lolo2438/VHDL_GUITAR_PEDAL/Rapport final/Rapport final.docx

Laurent Tremblay

Gr.001

Projet final

Pédale numérique pour effets de guitare

Travail présenté à

M. Jasmin St-Laurent, M. Claude Barbaud et Mme Chantal Milette

dans le cadre du cours

Projet de fin d’études, 243-631 — MA

Collège Maisonneuve

2018-05-14

# Introduction

Dans le cadre du cours de projet de fin d’études, j’ai réalisé un projet électronique ayant comme fonction de modifier un signal audio provenant d’une guitare à l’aide d’un FPGA. Celui-ci possède une interface graphique pour afficher à l’utilisateur l’effet actif ainsi que les paramètres de cet effet. L’utilisateur a à sa disposition deux boutons poussoirs pour avancer et reculer entre les multiples effets ainsi qu’un bouton pour activer les effets audios ou non. Parmi ces effets, on peut retrouver un effet de distorsion et un effet de trémolo. L’effet de distorsion consiste à limiter le signal audio pour ajouter des harmoniques à celui-ci, et l’effet de trémolo consiste à moduler le signal audio à l’aide d’une onde de fréquence très basse, ce qui donne l’impression qu’on augmente et réduit automatiquement le volume du son.

J’ai choisi ce projet, car je joue de la guitare et qu’il est important d’avoir des pédales à effets pour modifier le son de la guitare. Il y a aussi le fait que les pédales à effets pour guitare sont très couteuses, car une pédale peut coûter entre 75 et 500 dollars, et celle-ci ne produit qu’un seul effet. On peut donc s’imaginer qu’on peut se retrouver avec une grosse facture seulement en possédant quelques effets.

L’objectif du projet était donc de pouvoir créer tous les effets voulus pour une fraction du prix que l’ensemble des pédales standard pourraient couter. De plus, ce projet me donnait raison d’utiliser un FPGA, car ceux-ci sont extrêmement puissants pour le traitement de signaux numériques, et par ce fait approfondir mes connaissances au niveau de la composante et du langage VHDL.

# Bilan des travaux

Dans mon cahier des charges, il était spécifié que je devais créer cinq effets différents, chacun ayant trois paramètres modifiables, ainsi qu’implémenter une mémoire vive statique et un écran graphique pour pouvoir créer une pédale numérique. Cependant, suite aux modifications apportées au cours, je me suis vu enlever quelques modules du projet. Ceux-ci étaient trois des cinq effets ainsi que la mémoire vive statique. Suite aux changements, je devais créer deux effets ayant trois paramètres modifiables, soit un effet de distorsion ayant comme paramètres le contrôle du niveau de distorsion, le contrôle du « ton » du son, soit plusieurs filtres passes bas pour couper les hautes fréquences, et un paramètre pour le volume du son, soit un effet de trémolo ayant comme paramètres la fréquence de l’onde modulant le signal, la forme de l’onde modulant le signal et l’intensité de l’effet, ainsi que d’implémenter un afficheur graphique pour l’interface utilisateur. Parmi ces obligations, la seule que je n’ai pu réaliser était le paramètre pour modifier le ton de l’effet de distorsion. Cela est dû au fait que je n’ai pas implémenté la mémoire vive statique dans le projet, et donc dans le FPGA je n’avais pas assez d’espace pour implémenter les filtres nécessaires pour réaliser le circuit. Il y avait une autre option, soit d’utiliser une transformation de fourrier pour faire une analyse fréquentielle du signal et de multiplier les données par des coefficients, cependant je n’ai pas eu le temps d’analyser de sujet et de comprendre comment l’implémenter dans le projet.

# Description générale

## Schéma synoptique

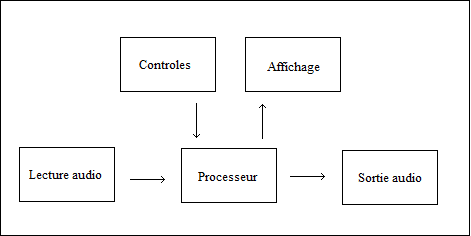
[picture p1: figure]

Le schéma démontre que le projet repose sur un module qui échantillonne un signal audio, et qui envoie les données au processeur, celui-ci traitant le signal qu’il lui est passé dépendamment des contrôles spécifiés par l’utilisateur.

## Schéma de principe

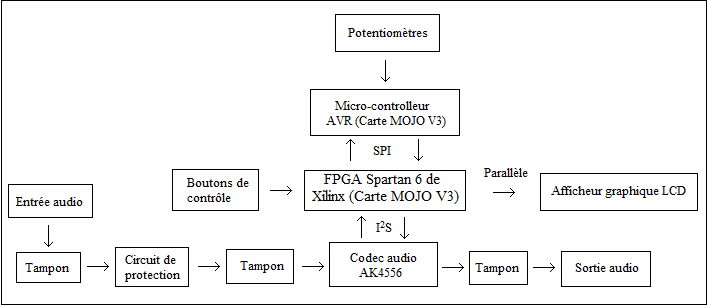
[picture p2: figure]

Il y a plusieurs principes utilisés dans ce projet. Ceux-ci peuvent être séparés en deux : soit une partie analogique et une partie numérique. Pour la partie analogique, il y a l’utilisation de l’amplificateur TL04 comme tampon et comme circuit de protection pour transmettre le signal audio au codec audio AK4556. Il est important d’utiliser un circuit tampon pour isoler les impédances, soit celle de l’entrée audio, celle de l’entrée du circuit d’acquisition du codec audio et celle à la sortie du codec audio. De plus, il faut aussi utiliser un circuit de protection pour limiter le niveau de tension de l’entrée audio, car elle pourrait endommager l’entrée du circuit d’acquisition du codec. Dans mon cas, j’ai choisi d’utiliser un circuit de compression audio : ce circuit ajuste automatiquement la tension du signal audio pour qu’elle soit à une tension fixe, prévenant les surtensions. En plus, ce choix permet d’avoir une meilleure résolution de notre signal audio, cependant il vient couper la dynamique du signal audio. Le deuxième aspect de la partie analogique est l’utilisation d’un codec audio, celui-ci permettant le suréchantillonnage et le filtrage du signal audio. Le but du suréchantillonnage est d’échantillonner le signal à une fréquence très élevée (dans notre cas autour de 512 fois plus élevé) pour augmenter le rapport signal à bruit du signal et pour réduire la taille du filtre anticrénelage nécessaire pour éviter que la fréquence échantillonnée dépasse le théorème de Nyquist-Shannon sur l’échantillonnage. La communication entre le codec audio et le FPGA se fait à l’aide du protocole I²S.

Pour la partie numérique, on peut retrouver une interface pour l’utilisateur ainsi que plusieurs protocoles de communications. L’utilisateur possède trois boutons de contrôles, soit deux pour changer de pages (précédent et prochain) ainsi qu’un bouton activant la pédale. L’utilisateur peut aussi modifier les paramètres des effets à l’aide de trois potentiomètres. Les tensions de ces potentiomètres sont lues à l’aide des convertisseurs analogiques à numérique du microcontrôleur AVR sur la carte MOJO V3. Ils sont ensuite transmis à l’aide du protocole SPI au FPGA Spartan 6. Le dernier item de l’interface utilisateur est un afficheur graphique LCD. Le FPGA envoie des données en parallèle à l’afficheur, car l’interface est plus facile à implémenter par rapport à un protocole comme le SPI ou le I²C.

# Description précise

## Schéma de montage

### Plaquette principale

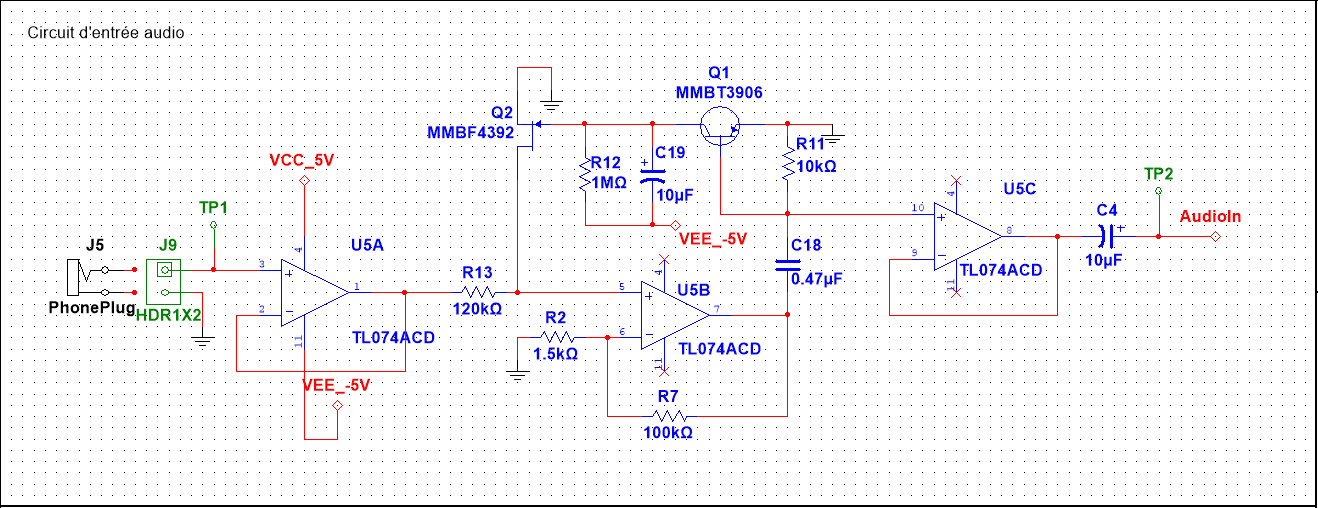
[picture p3: figure]

Le circuit d’entrée audio comporte trois étages. Le premier étage est un suiveur qui isole l’impédance de la guitare et celle du circuit. Le deuxième étage est un circuit de compression audio, régulant le signal d’entrée pour qu’il soit toujours à 1,31 volt. Ce circuit est important pour protéger l’entrée du convertisseur analogique à numérique du codec audio AK4556. De plus, il permet d’utiliser une plus grande résolution du convertisseur analogique à numérique. Le troisième étage est un autre suiveur qui isole l’impédance du circuit de compression et l’impédance du convertisseur analogique à numérique du codec audio. Il possède un condensateur à sa sortie pour couper le décalage courant continu.

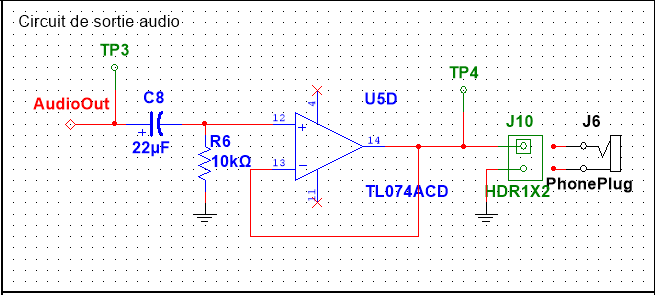
[picture p4: figure]

En contrepartie, le circuit audio de sortie comporte un seul étage, soit un circuit suiveur, qui vient isoler la sortie du convertisseur numérique à analogique du codec audio AK4556. Il possède aussi un filtre passe-haut à son entrée pour couper le décalage courant continu.

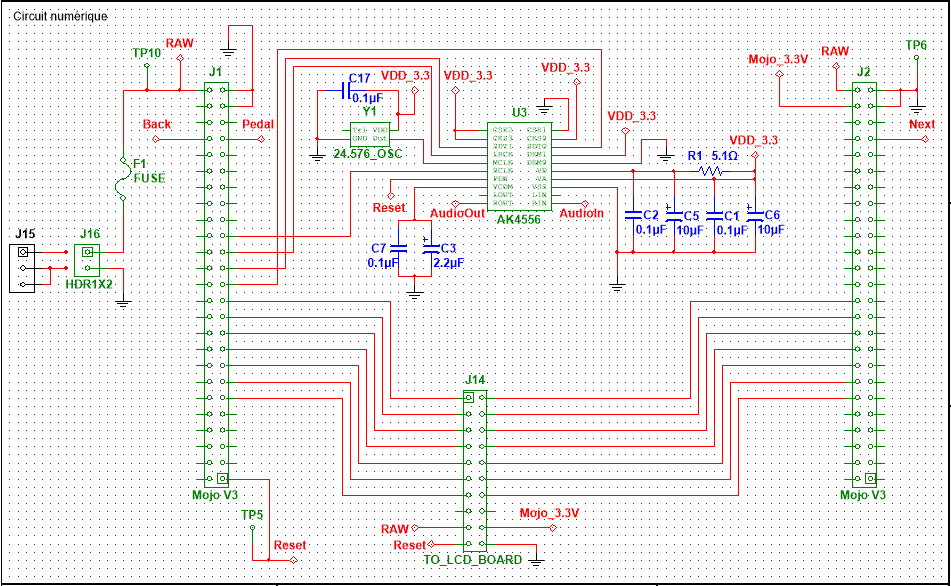
[picture p5: figure]

Le circuit principal du projet se retrouve ici. Le connecteur J15 est une entrée pour le bloc d’alimentation 9 V. Le connecteur J14 permet le lien entre la plaquette principale et la plaquette pour l’écran graphique. Les connecteurs J1 et J2 font le lien entre la carte Mojo et les circuits du projet. Dans ce circuit, on retrouve le codec AK4556, qui est responsable de l’échantillonnage du signal audio.

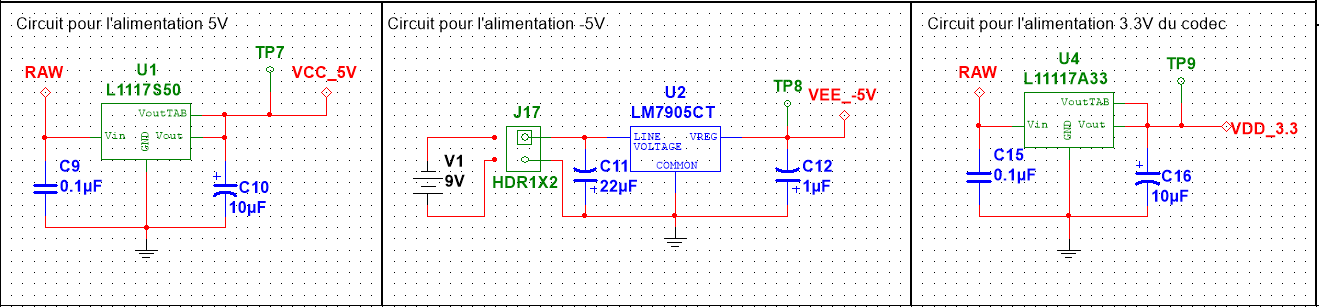
[picture p6: figure]

La plaquette utilise trois alimentations, soit 5 volts et -5 volts pour l’alimentation de l’amplificateur opérationnel TL074 utilisé dans les circuits audios, ainsi que 3,3 V pour alimenter le codec audio. Il est important de noter que la carte Mojo V3 possède ses propres régulateurs, alors la tension brute du bloc d’alimentation est directement liée à l’entrée de la carte. Aussi, une pile 9V est nécessaire pour obtenir la tension négative requise de l’amplificateur opérationnel TL074.

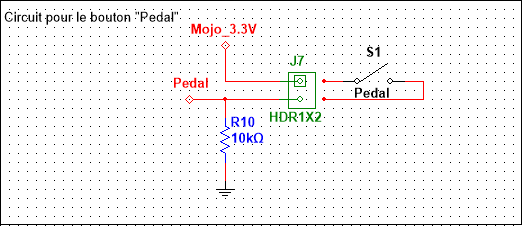
[picture p7: figure]

Le même circuit est utilisé pour les boutons « Pédale », « Suivant » et « Précédent ».

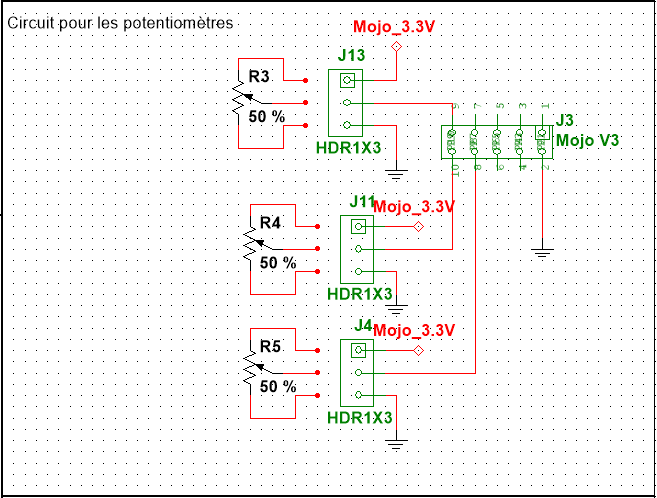
[picture p8: figure]

Ce circuit est utilisé pour pouvoir lire la tension des potentiomètres utilisés pour modifier les paramètres des effets. Ceux-ci sont connectés au connecteur J3, qui est relié aux convertisseurs analogiques à numériques du microcontrôleur Atmel de la carte Mojo.

**Le circuit principal complet peut être trouvé à l’annexe.

### Circuit pour l’écran graphique

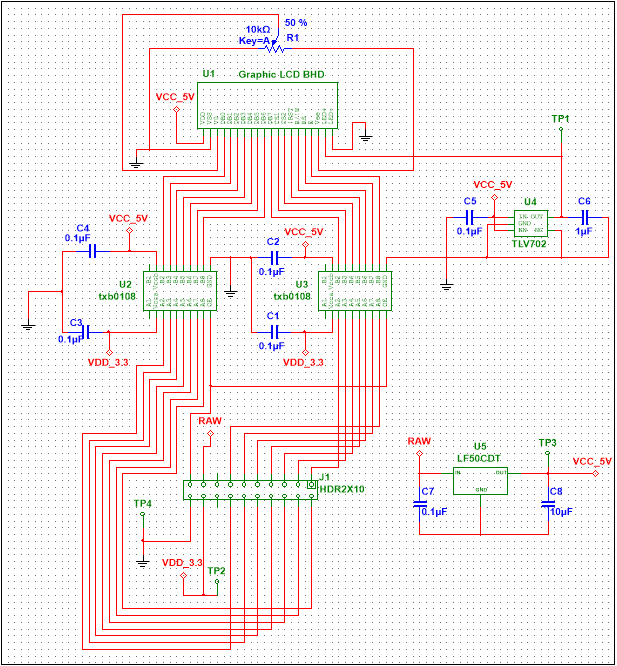
[picture p9: figure]

Ce circuit est le circuit complet pour interfacer l’afficheur LCD avec le FPGA. Le connecteur J1 permet la liaison entre les deux plaquettes. Le circuit possède deux régulateurs : un LF50CDT régule la tension à 5 V, soit l’alimentation nécessaire pour la logique de l’écran, et un TLV02 qui régule la tension à 3,5 V, soit l’alimentation nécessaire pour alimenter le rétroéclairage de l’écran. Le circuit possède aussi deux composantes TXB0108, qui eux convertissent la tension provenant des tampons de sortie du FPGA, soit 3,3 V, à la tension nécessaire pour la logique de l’écran, soit 5V.

## Circuit imprimé

### Circuit imprimé pour le circuit principal

Copper Top

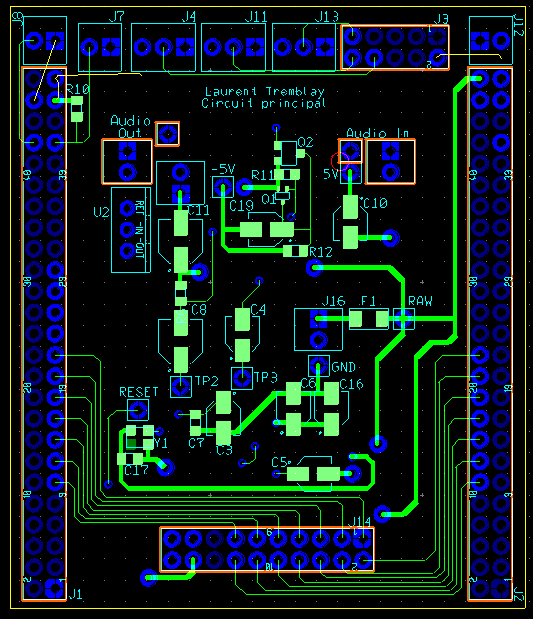
[picture p10: figure]

« Copper Bottom »

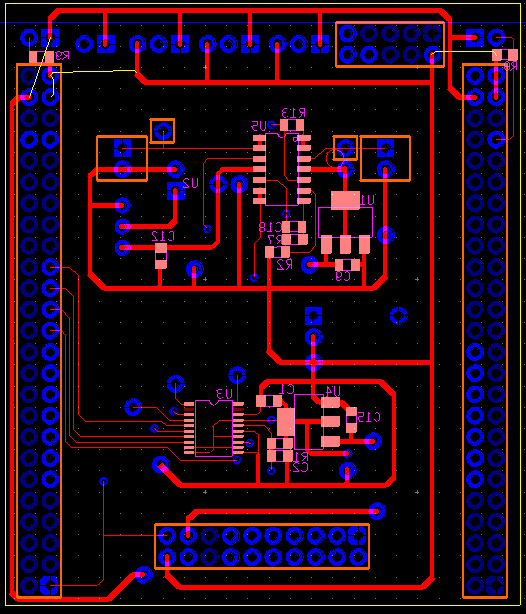
[picture p11: figure]

Les images ci-haut sont les côtés haut (top) et bas (botom) du circuit principal. Les connexions non reliées en jaune sont effectuées lorsque le circuit est inséré dans la carte Mojo V3. De plus, l’erreur indiquée par le point de test de l’entrée audio et de l’alimentation 5V étant trop rapproché n’est pas réellement une erreur étant donné que ceux-ci sont à 100 millièmes de pouce de distance.

### Circuit imprimé pour l’écran LCD

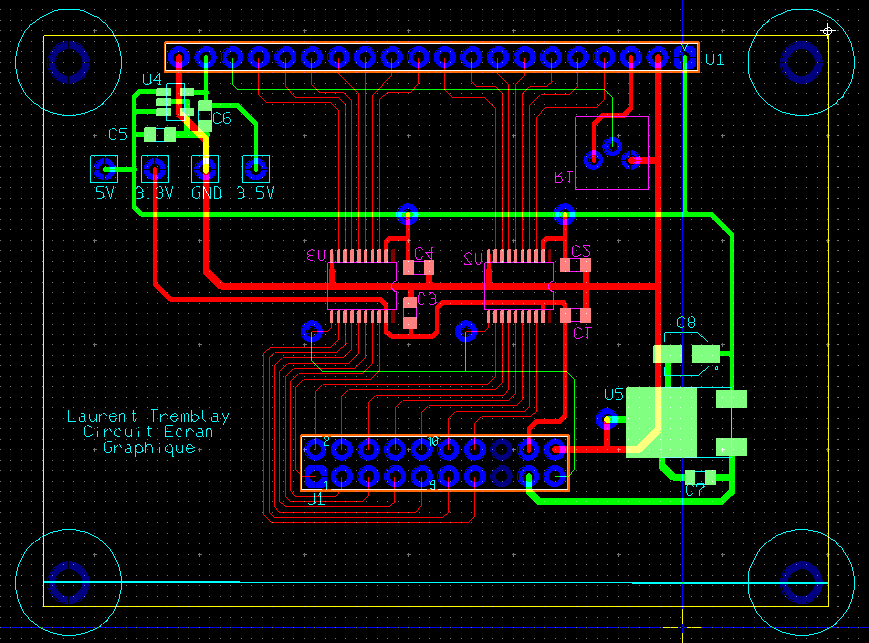
[picture p12: figure]

Ce circuit imprimé est utilisé pour alimenter l’écran graphique et pour transformer la tension 3.3V provenant FPGA pour qu’il soit converti à 5 V. La ligne bleue sérigraphiée vers le bas de la plaquette nous indique où il faut couper pour enlever l’excès.

## Câbles

Le projet utilise deux types de câbles : un câble de type ruban plat et des câbles sertis qui sont insérés dans les connecteurs.

Le câble plat est utilisé pour échanger des données entre la carte principale et la carte de l’écran LCD. Il comporte 20 conducteurs ayant une taille de 28 AWG et doit être d’une longueur de 7 pouces.

Les câbles sertis sont utilisés pour attacher les composantes externes, soit les boutons, les potentiomètres, l’entrée et la sortie audio, ainsi que l’alimentation, au circuit principal. Ils ont tous une taille de 22 AWG. Les câbles des alimentations ont une longueur d’environ cinq pouces et doivent être de couleur rouge pour l’alimentation, et noire pour la masse. Les câbles pour les boutons et les potentiomètres, qui eux ont une longueur d’environ 2,5 pouces, suivent la même règle de couleur pour les alimentations, cependant le câble comportant les données numériques ou analogiques doit être de couleur blanche. Finalement, les câbles portant les informations du signal audio sont de couleur bleue et à une longueur d’environ 2,5 pouces.

## Programmes

Circuit principal (« TOP »)

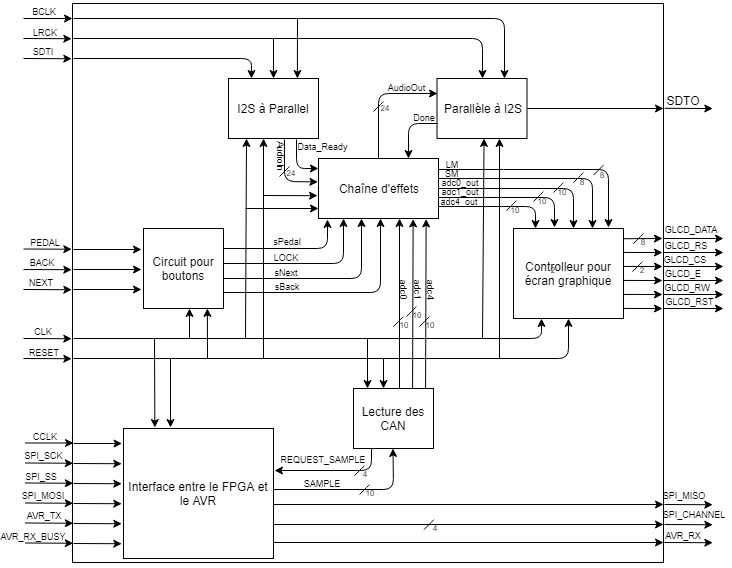
[picture p13: figure]

I²S à Parallèle

Ce module permet la réception de données I2S provenant du codec audio AK4556. Il reçoit une trame de 24 bits qui sont échantillonnés sur front montant de l’horloge « bit », et qui représentent les canaux audios droit et gauche dépendamment du niveau de l’horloge « Left/Right (LR) ». Le processus est réalisé à l’aide d’un registre à décalage, qui lorsque plein, envoie un signal à l’utilisateur.

Parallèle à I²S

Ce module permet de prendre un registre et de le convertir en trame I2S. Pour ce faire, le module détecte un changement de niveau logique dans l’horloge sélectionnant le canal droit ou gauche, puis envoie les bits du registre à l’aide d’un registre à décalage. Lorsque toutes les données sont envoyées, le module envoie un signal disant qu’il est prêt à recevoir une nouvelle donnée dans son registre.

Interface entre le FPGA et le AVR

Ce module a été écrit par l’équipe de Embedded Micro en Verilog, puis a été traduite en VHDL par l’utilisateur Xark. Il est libre d’utilisation pour tous. Le module permet de faire la communication entre le microcontrôleur AVR et le FPGA se retrouvant sur la carte Mojo V3 pour ainsi lire les convertisseurs analogiques à numérique du microcontrôleur AVR. La communication entre les deux composantes se fait à l’aide du protocole SPI. L’interface permet aussi d’envoyer des données UART, cependant cette fonctionnalité n’est pas utilisée dans le cadre du projet.

Lecture des CAN

Ce module a été écrit dans le but de gérer l’entrée de donnée des convertisseurs analogiques à numériques. Il communique directement avec le circuit d’interface entre le FPGA et le AVR en lui demandant le canal du convertisseur analogue à numérique qu’il veut lire. Le module échantillonne 10 fois le convertisseur analogue à numérique avant d’entreposer la 11e donnée dans un registre. Cela permet au convertisseur du microcontrôleur AVR de se stabiliser, car sinon les données sont erronées. Il exécute les mêmes actions pour les autres canaux, pour revenir finalement au canal de départ.

Chaîne d’effets

Ce module permet de facilement enfiler et de sélectionner les effets programmés dans le FPGA. Il permet aussi de facilement interfacer les paramètres actifs de l’effet ainsi que le statut de l’effet, soit s’il est sélectionné ou s’il est bloqué, au circuit du contrôleur de l’écran graphique.

Distorsion

L’effet de distorsion consiste à ajouter des harmoniques au signal échantillonné. Le principe utilisé pour appliquer cet effet est d’appliquer un seuil au signal d’entré, et de couper tout ce qui plus grand (et plus petit lorsque le signal est négatif). Plus on augmente le niveau de distorsion, plus on augmente le gain appliqué à l’onde d’entrée, et étant donné que le seuil reste fixe, la forme de l’onde devient de plus en plus carrée. On peut ensuite décider d’amplifier le volume de l’onde distorsionnée à l’aide du paramètre de volume, qui vient multiplier cette onde par un gain variable. Bien que le paramètre modifiant le ton du signal n’ai pas été implémenté, il peut être retrouvé dans le fichier toneFiltreFIR.vhd inclus à l’annexe. Il consiste de 15 filtres impulsionnels à réponse fini de 39 coefficients qui sont sélectionnables à l’aide de la valeur du convertisseur analogue à numérique #1. En changeant la fréquence des filtres, on vient faire en sorte que la tonalité du signal devient plus grasse ou plus aiguë. Le programme devrait être plus optimisé lors de l’utilisation d’une mémoire vive statique.

Trémolo

L’effet de trémolo consiste à multiplier le signal échantillonné par une onde de basse fréquence, ce qui donne l’impression qu’on augmente et diminue le son du signal rapidement. Pour appliquer cet effet, le module génère une onde triangulaire ou carrée, dépendamment du paramètre nommé « wave », qui signifie forme de l’onde, puis on multiplie le signal entrant dans le module par la cette onde. On peut choisir de réduire ou d’augmenter la fréquence de l’onde générée en modifiant le paramètre « rate ». On peut aussi modifier l’intensité de l’effet en modifiant le paramètre « depth ». Le principe de l’intensité consiste à augmenter ou réduire la plage de l’onde générée. En effet, si on assume que l’effet n’est en fait qu’un gain variable, en réduisant la plage du gain, on réduit l’écart entre les niveaux de tensions, ce qui fait en sorte que l’effet est moins remarqué.

Circuit pour boutons

Ce module permet d’analyser les boutons disponibles à l’utilisateur. Ce module se sépare en deux catégories : le bouton qui active la pédale et les deux boutons pour changer le type d’effet appliqué. Parmi les sous-modules utilisés, il y a un module d’anti rebond créer par le professeur Jasmin St-Laurent du collège de Maisonneuve. J’ai obtenu son autorisation pour l’utilisation de son module.

Bouton « pédale »

Pour le signal du bouton contrôlant si la pédale est active ou non, étant donné que le circuit de ce bouton est en fait un interrupteur ouvert ou fermé, on applique un anti-rebond de 10 millisecondes. En parallèle, il y a un processus qui observe si l’utilisateur réappuie sur le bouton dans l’espace de 500 millisecondes. Si c’est le cas, un signal est envoyé au module s’occupant des effets, indiquant que l’utilisateur veut bloquer les paramètres de l’effet actuellement actif.

Bouton « suivant » et « précédent »

Pour le signal des boutons suivant et précédent, on applique un anti-rebond de 10 millisecondes, puis lorsque l’anti-rebond est appliqué, on envoie un signal durant un coup d’horloge au module d’effet indiquant qu’on change d’effet.

Contrôleur pour écran graphique

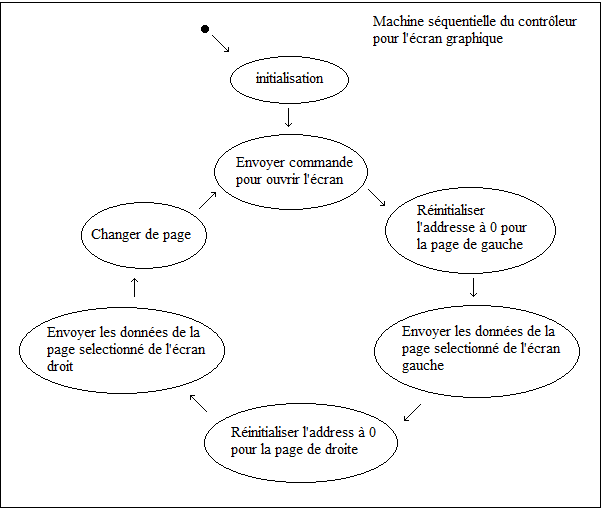
[picture p14: figure]

Le module contrôlant l’écran graphique est une machine séquentielle ayant 7 états, ceux-ci étant synchronisés sur une horloge nommée E pour « enable » (activé). Lorsqu’il y a un front descendant sur cette horloge, le contrôleur sur la carte de l’écran graphique lit les données. La machine séquentielle recharge ses données sur le front montant de cette horloge, puis effectue ses actions sur le front descendant, soit de changer d’état ou d’incrémenter des compteurs, étant donné que l’écran lit les données chargées lors du front montant. Le premier état est celui de l’initialisation, où on met tous les signaux ainsi que les variables du processus a leurs valeurs initiales. De plus, on applique un signal « reset » au contrôleur de l’écran pendant 2,4 microsecondes. On tombe ensuite dans l’état où on envoie la commande nécessaire pour ouvrir l’écran. On passe ensuite au prochain état où on envoie les 64 premiers octets de la page, soit la moitié de l’écran. Lorsque tout est envoyé, on change pour le côté droit de l’écran et on réinitialise l’adresse à 0. On envoie ensuite les 64 derniers octets pour du tableau de donnés, et lorsque cela est fait, on envoie une commande à l’écran pour qu’il change de page. Pour s’assurer que l’écran fonctionne toujours, même si on le débranche ou que le FPGA s’allume avant celui-ci, on renvoie la commande pour allumer l’écran.

Plan

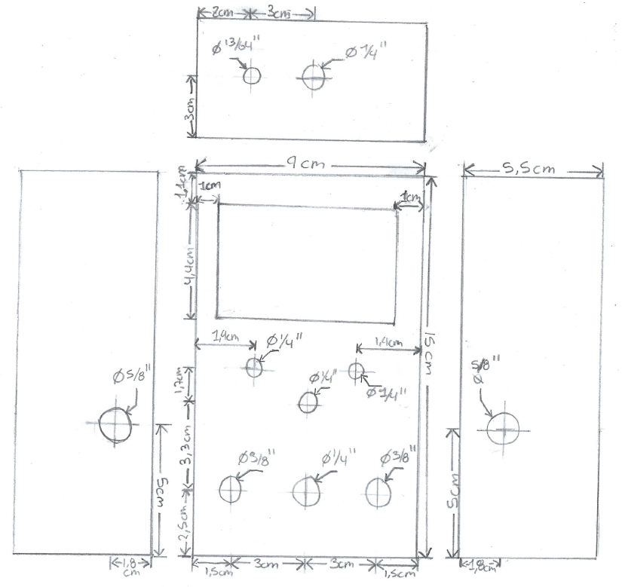
[picture p15: figure]

Les dimensions du boitier sont spécifiées en centimètres.

Les dimensions des trous sont spécifiées en pouces, pour faciliter la sélection de la taille de la mèche utilisée pour percer le trou.

Le boitier utilisé est en plastique. Ce choix a été fait à cause de son faible coût et sa facilité de manipulation.

## Caractéristiques et limites de l’appareil

Consommation d’énergie : Alimentation positive : 1,35 Watt

Alimentation négative : 0,045 Watt

Autonomie : 100 heures avant de changer la batterie

Type d’alimentation : Prise murale 9V et pile 9V

Milieu : Maison et studio

Température : 0º Celsius à 40º Celsius

Plage de fonctionnement : Fréquence minimale pouvant être échantillonnée : 20 Hz

Fréquence maximale pouvant être échantillonnée : 24 kHz

Vitesse d’acquisition du signal audio : 48 kHz

## Liste de matériel

Processeur

* Le circuit principal est inséré dans la carte Mojo V3, d’où son absence de RefDes

Composantes passives

* Le bouton activant la pédale ne se retrouve pas sur le site internet de Digikey, il peut être acheté chez Addison (lien internet (https://addison-electronique.com/interrupteur-a-bouton-poussoir-on-off-2-pins-spst.html)).

Composantes actives

Connecteurs

* Le connecteur est représenté par la composante de l’écran LCD

** il est préférable d’acheter des connecteurs de taille standard et de les couper, pour des raisons de coût trop élevé.

Accessoires

* Le boitier utilisé ne se retrouve pas sur Digikey, il peut être acheté chez Abra Electronics (lien internet (https://abra-electronics.com/enclosures-boxes/plastic-box-generic/gpb435-plastic-box-4.875l-x-2.5w-x-1.5h.html)).

## Évaluation des coûts de production

Les coûts de production se séparent en cinq catégories : le processeur, les composantes passives, les composantes actives, les connecteurs et les accessoires.

Le processeur central, soit le FPGA, se retrouve sur la carte Mojo V3, qui elle se vend à 129,96 CAD.

Les composantes passives, soit les résistances, les potentiomètres, les condensateurs, les boutons, l’interrupteur pour l’alimentation et le fusible, coûtent au maximum 22 dollars canadiens, le plus cher étant les boutons et les potentiomètres.

Les composantes actives, soit les régulateurs, les transistors, l’amplificateur opérationnel, l’adaptateur de tension, l’écran graphique ainsi que le codec audio, sont estimées à un coût total d’environ 42 dollars canadiens, le plus cher étant l’écran graphique coûtant 32 dollars canadiens.

L’ensemble des connecteurs, incluant les pièces pour sertir les câbles, le connecteur pour le bloc d’alimentation, le connecteur pour la pile 9 volts, les connecteurs pour les entrées audios et le câble en ruban 20 positions, coûtent autour de 25 dollars canadiens, le plus cher étant le câble ruban, celui-ci coutant 7,50 $.

Les accessoires englobent toutes les parties du projet qui sont externes. Ils peuvent coûter plus ou moins cher et sont facilement remplaçables. Cela comprend les poignées des potentiomètres, la pile 9V, le bloc d’alimentation 9 volts ainsi que le boitier. Le coût des accessoires est estimé à 35 dollars canadiens.

Au total, le projet est estimé à 255 dollars canadiens sans taxes et sans circuits imprimés.

# Procédure d’assemblage

Étape 1 : Imprimer circuits

Pour faire imprimer les circuits imprimés du projet, il faut envoyer les fichiers gerber à une compagnie pour qu’ils les fassent. En effet, certaines traces sont trop petites pour que la plaquette soit faite à la maison. Un site recommandé pour l’impression des plaquettes est allPCB. Ceux-ci envoient en une semaine des plaquettes professionnellement faites à un faible prix.

Étape 2 : Souder composantes

Lorsque les plaquettes ont été reçues, il faut souder toutes les composantes en se référant au schéma Multisim et Ultiboard inclus à l’annexe pour s’assurer que toutes les composantes sont soudées à la bonne place. Un fer à souder chauffer à une température de 400 dégrées Celsius, de l’étain de taille 22 AWG pour les composantes soudées dans les trous et de l’étain de taille 27 AWG sont les outils nécessaires pour souder les composantes montées en surface. Il est fortement recommandé d’utiliser un microscope pour souder les composantes montées en surface.

Étape 3 : Percer boitier

En suivant les détails spécifiés plus hauts sur le boitier, il suffit de suivre les schémas pour percer les trous des tailles spécifiés à la bonne place à l’aide d’une perceuse. Lorsque le trou est très gros, il est préférable de commencer par percer un trou plus petit et augmenter de taille progressivement pour ne pas briser le matériel du boitier. Pour le trou de l’écran, il faut utiliser une scie rotative pour créer un trou un peu plus petit que celui étant spécifié et ensuite sabler les côtés pour que l’écran soit serré.

Étape 4 : Sertir les câbles et les insérer dans les connecteurs

En utilisant un outil pour sertir des câbles d’une taille de 22 AWG, on peut sertir les connecteurs à sertir aux câbles mentionnés plus hauts. Il est seulement nécessaire de sertir qu’un seul côté du câble, étant donné que l’autre côté sera soudé à un périphérique externe. Pour sertir un câble, il suffit de dégainer environ 0,5 cm de celui-ci à l’aide d’un outil pour dégainer et de le sertir à l’aide de l’outil à sertir. Lorsque tous les câbles sont sertis, il faut les insérés dans le connecteur correspondant, suivant le code de couleur indiqué dans la section câble, soit rouge pour alimentation positive ou négative, noir pour la masse, blanc pour données des potentiomètres et des boutons ainsi que bleu pour l’entrée et la sortie audio. Pour le câble en forme de ruban, il faut fermer les deux connecteurs femelles 20 positions sur le câble à l’aide d’un étau pour bien le dégainer.

Étape 5 : Souder les fils aux périphériques externes

La partie non sertie des câbles doit être soudée aux périphériques externes, soit les potentiomètres, l’alimentation, les boutons et les entrées audios. Pour ce faire, il faut commencer par dégainer environ 1 centimètre du câble et de faire une forme de crochet avec celui-ci. Il faut ensuite placer un tube thermo rétractable d’une longueur d’environ 1,5 cm autour du câble à souder et de le garder loin de la chaleur du fer. Lorsque cela est fait, il ne reste que d’insérer le crochet dans la fente prévue de la pièce, tout en suivant le schéma électrique, de souder le câble à la composante, et de chauffer le tube thermorétractable par-dessus la nouvelle soudure, évitant ainsi les possibilités de courts-circuits.

Étape 6 : Installer les cartes et les composantes externes

Pour cette étape, il suffit d’installer les composantes externes dans leurs trous respectifs. Il faut aussi installer la pile 9VDC ainsi que les poignées pour les potentiomètres. Lorsqu’on installe les poignées, il faut s’assurer que lorsque la tension sortant du potentiomètre est de 1.65VDC. Lorsque cela est le cas, il suffit d’aligner la barre blanche de la poignée pour qu’elle pointe droit vers l’écran. En se référant au manuel de l’utilisateur ainsi qu’aux deux images ci-dessous, on peut observer l’emplacement de chaque composante par rapport aux schémas de boitiers.

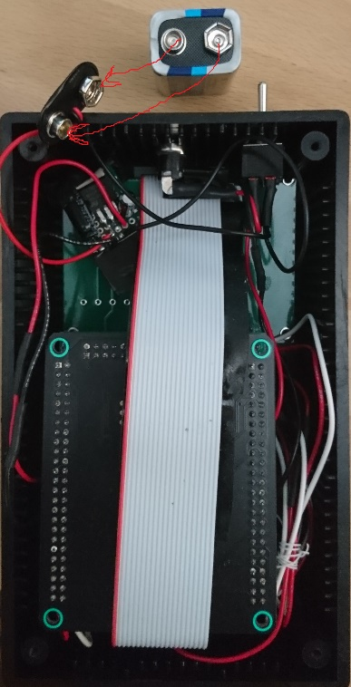
[picture p16: figure]
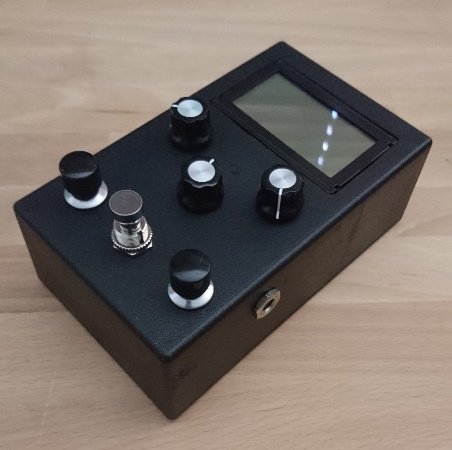
[picture p17: figure]

Étape 7 : Installer le programme

Lorsque le projet est alimenté par l’alimentation externe ainsi que la pile 9VDC, il faut connecter un câble USB de type micro à la carte Mojo V3 et le connecter à un ordinateur. Il faut ensuite installer le programme nommé « Mojo loader » (lien pour téléchargement (https://embeddedmicro.com/pages/mojo-loader)), créer par l’équipe de Embedded Micro, soit les concepteurs de la carte Mojo v3, pour pouvoir programmer la carte. Lorsque le programme sera ouvert, suffit de choisir le port de communication de la carte, de rechercher le fichier PedaleMultiEffets.bit, soit le circuit du projet, à l’aide du bouton « Browse », de cocher le bouton « Store to Flash » et « Verify Flash » pour que le programme soit chargé même si l’alimentation est coupée et finalement d’appuyer sur le bouton « Load » pour télécharger le programme dans le FPGA ainsi que sa mémoire externe.

# Procédure de calibration

Le projet requiert quelques calibrations. La première est d’ajuster le potentiomètre « R1 », sur le circuit imprimé de l’écran, pour ajuster le rétroéclairage du LCD. Il faut ajuster cette résistance pour que la tension obtenue à la broche #3 de l’écran graphique soit de -3,5 volts. La deuxième calibration implique que les trois potentiomètres utilisés pour la modification des effets sont installés dans le boitier. Il faut les ajuster pour que la tension affichée sur leur broche du milieu soit de 1,65 volt. Lorsque cela sera le cas, il faudra installer les poignées pour que la petite barre blanche pointe droit vers l’écran.

# Manuel de l’utilisateur

La pédale à multieffets numériques permet d’appliquer plusieurs effets à votre guitare pour créer le son qui vous convient. Celle-ci est équipée de trois sélecteurs qui permettent de modifier les paramètres des effets, de deux boutons pour changer l’effet actif, d’un bouton pour activer ou désactiver l’application de l’effet ainsi qu’un interrupteur pour activer ou désactiver l’alimentation.

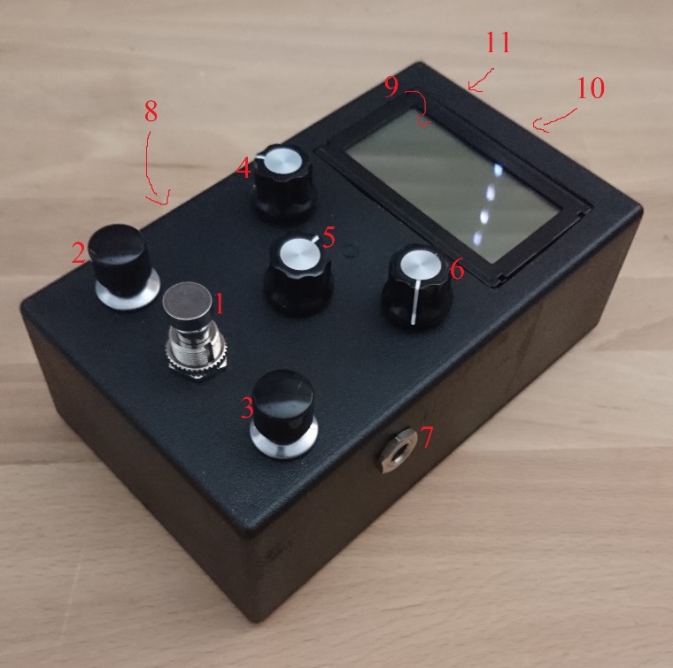
[picture p18: figure]

1. Activer ou désactiver la pédale

2. Effet précédent

3. Effet suivant

4. Paramètre nº 1 de l’effet

5. Paramètre nº 2 de l’effet

6. Paramètre nº 3 de l’effet

7. Entrée audio mono

8. Sortie audio mono

9. Affichage pour l’utilisateur

10. Entrée pour alimentation murale 9VDC*

11. Interrupteur pour activer l’alimentation

*Attention, l’alimentation murale doit respecter ce symbole :

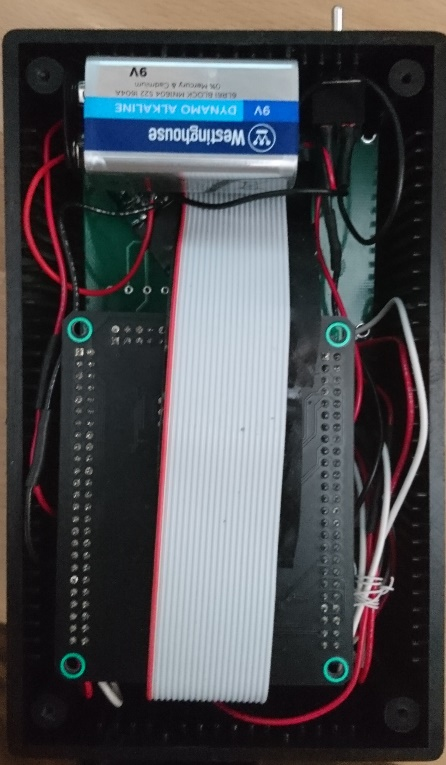
[picture p19: figure]

Pour utiliser l’appareil, il faut en premier lieu brancher une pile 9V à l’intérieur de la pédale. À l’aide d’un tournevis en forme étoile, on enlève les quatre vis sous l’appareil pour révéler le circuit. Lorsque cela est fait, il faut remettre les quatre vis et fermer le boitier.

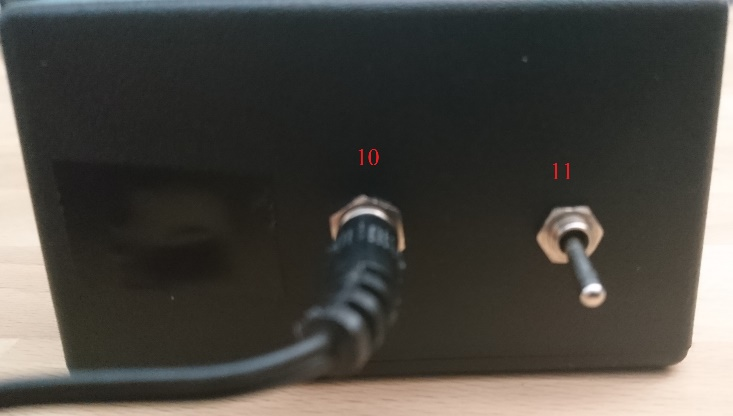
[picture p20: figure]

Il faut ensuite insérer l’alimentation 9VDC et activer l’interrupteur.

Lorsque l’interrupteur est vers le bas, l’alimentation est coupée, et lorsqu’il est vers le haut, le circuit est alimenté.

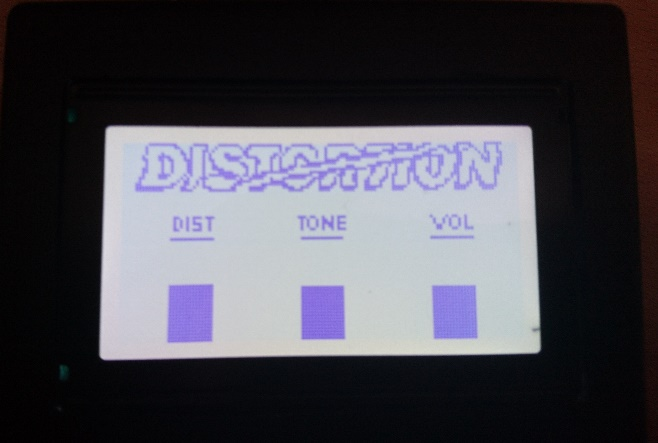
[picture p21: figure]

Lorsque la pédale sera alimentée, l’écran s’ouvrira et affichera le premier effet de la liste, soit l’effet de distorsion ici. À partir d’ici, on peut jouer avec les trois sélecteurs (4,5 et 6) pour modifier les paramètres de l’effet. Ces sélecteurs sont alignés respectivement avec les paramètres affichés à l’écran.

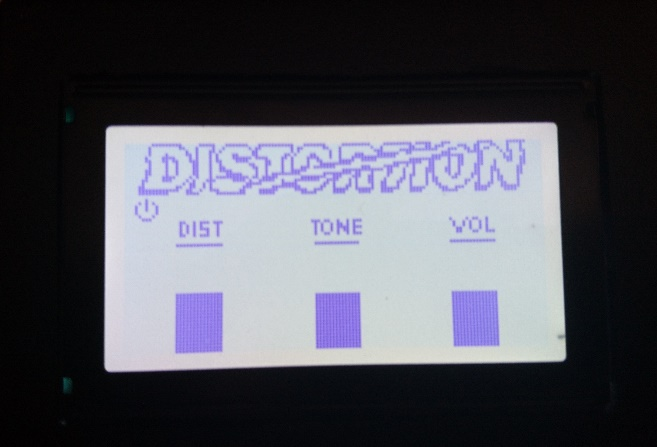
[picture p22: figure]

Lorsqu’on appuie sur le bouton nº 1, un symbole va s’afficher en haut, à gauche de l’écran, nous indiquant que l’effet est actuellement actif.

Lorsqu’on appuie deux fois sur le bouton nº 1, un symbole va s’afficher en haut, à droite de l’écran, nous indiquant que l’effet est actuellement bloqué. Cela veut dire que l’on ne peut plus changer les paramètres de l’effet tant et aussi longtemps que l’on ne débloque pas le module, soit en réappuyant deux fois sur le bouton nº 1.

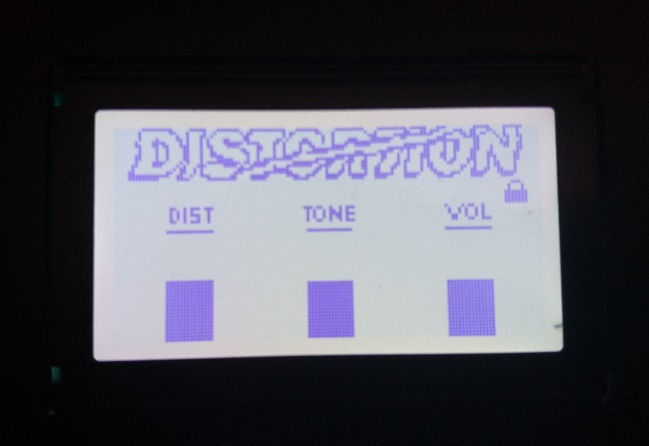
[picture p23: figure]

En appuyant sur les boutons nº 2 et nº 3, on peut changer l’effet appliqué sur le son de la guitare. L’afficheur indiquera l’effet actuellement actif.

Il faut insérer la sortie de la guitare dans l’entrée audio (nº 7), et la sortie audio (nº 8) dans l’entrée de l’amplificateur.

L’appareil a été conçu dans le but d’être utilisé à l’intérieur d’un bâtiment ayant des conditions optimales, soit une température autour de 20 dégrées Celsius, ainsi qu’un taux d’humidité convenable. Il est donc fortement déconseillé d’utiliser l’appareil à l’extérieur, étant donné que celui-ci n’est pas résistant aux intempéries, aux hautes températures ainsi qu’aux hauts taux d’humidité. L’appareil ne peut pas non plus être utilisé ni entreposé à une température au-dessous de zéro dégrées Celsius. Il est fortement déconseillé de l’utiliser pour des concerts extérieurs.

Il est important de ne pas utiliser une alimentation murale supérieure à 9 volts courants continus, car l’équipement n’est pas conçu pour de hautes tensions. Il est important aussi de noter que contrairement à l’équipement standard de musique, le connecteur de l’alimentation murale doit être positif au centre et négatif autour (symbole plus haut dans le manuel). Il est fortement conseillé de désactiver l’alimentation à l’aide de l’interrupteur (nº 11) avant de changer la batterie ou d’insérer le connecteur de l’alimentation murale. Il faut aussi faire attention avec l’afficheur : il ne faut pas le percer ni le toucher, car le liquide de l’écran est nocif.

# Conclusion

### Évaluation du choix matériel

S’il était question de recommencer le même projet, je crois qu’il serait plus intéressant d’utiliser un processeur adapté au traitement des signaux numériques à la place d’un FPGA. Bien sûr, le FPGA permet d’avoir une latence très faible entre l’entrée et la sortie du signal audio grâce à la parallélisation des calculs, cependant, un processeur adapté pour le traitement de signaux numérique permet d’obtenir des résultats presque équivalents beaucoup facilement. En effet, étant donné que ceux-ci sont conçus dans l’optique de traiter les signaux, ils possèdent plusieurs périphériques internes permettant d’effectuer des calculs intenses comme des transformations de fourrier et des divisions très rapidement. Ces périphériques sont déjà optimisés, ce qui est un avantage comparé au FPGA, où il faut tout concevoir de A à Z, et où le temps d’optimisation est plus important que le temps de conception. De plus, le FPGA a besoin de plusieurs périphériques pour fonctionner, comme de la mémoire, un programmeur, etc. Comparer au processeur de signaux numériques, qui peut fonctionner seul, ou avec quelques petites composantes externes comme des oscillateurs. Toutes ces composantes viennent augmenter la taille du projet, et étant donné que les pédales vendues sur le marché sont relativement petites, il serait beaucoup plus intéressant d’utiliser un processeur de signaux numériques pour réduire la taille de la plaquette.

### Modifications éventuelles à apporter

Pour améliorer le projet, il y a plusieurs modifications à apporter. Premièrement, il faudrait utiliser un écran LCD plus petit et adapté aux tensions du processeur. En effet, l’écran prend énormément de place, et à cause de cela il faut lui faire sa propre plaquette pour pouvoir faire les connexions entre ses broches espacées. De plus, il requiert une tension de 5 V pour les niveaux logiques hauts, ce que le processeur ne peut pas fournir. Tous ces facteurs viennent grandement augmenter le coût de production, alors comme amélioration, il serait question de trouver un écran ayant un connecteur intégré qui communique avec des niveaux de tensions « hauts » de même valeur que celle du processeur. Le connecteur permettrait de connecter l’écran directement au circuit principal, et étant donné que l’on n’aura pas besoin d’adaptateurs de tensions entre le processeur et l’écran, il sera possible de les connecter directement. Deuxièmement, le circuit de compression audio devrait être amélioré. En effet, ce circuit devrait être modifié pour qu’il utilise la plage entière du convertisseur 24 bits du codec audio, et il devrait avoir un temps de réponse plus rapide. De plus, celui-ci semble avoir un problème avec les tensions trop hautes, alors il serait question d’ajouter un circuit de pré amplification pour automatiquement régler la tension provenant de la guitare à un niveau relativement faible pour que le compresseur fonctionne correctement. On pourrait aussi choisir d’améliorer les composantes utilisées pour générer le moins de bruit possible. Troisièmement, il faudrait ajouter une mémoire vive statique ou une mémoire vive dynamique externe. En effet, le projet nécessite une mémoire pour temporairement entreposer les PEPS (première entrée, première sortie) utilisés lors de l’intégration de filtres à réponse impulsionnelle finie ou lors de l’intégration de filtres à réponse impulsionnelle infinie. Le FPGA Spartan 6 utilisé lors de ce projet ne possède pas assez de mémoire interne pour permettre l’intégration de multiples filtres dans le cadre de la création des effets, ce qui est peu intéressant étant donné qu’il est nécessaire de produire des filtres lorsqu’on traite un signal audio. Dernièrement, une amélioration très intéressante serait d’ajouter un circuit qui permettrait d’avoir une alimentation bipolaire à l’aide d’une alimentation unipolaire. Pour obtenir le moins de bruits possible, il est important d’utiliser un amplificateur nécessitant une alimentation bipolaire, ce qui fait en sorte qu’on se retrouve avec deux alimentations à la place d’une. Pour éliminer cela, il faudrait ajouter un circuit, soit un convertisseur courant continu à courant continu (DC-DC) pour obtenir une tension négative à l’aide de notre tension positive.

### Difficultés rencontrées

Durant la conception du projet, je suis tombé face à face avec plusieurs problèmes. Premièrement, je me suis rendu compte assez rapidement qu’on ne pouvait pas simplement générer une tension négative en inversant les broches d’un régulateur. En effet, pour que cela fonctionne, il faut utiliser un convertisseur courant continu à courant continu, soit un détail que je n’avais aucunement prévu. Comme solution rapide, j’ai dû ajouter une pile 9 volts ainsi qu’un régulateur négatif pour obtenir une tension négative régulée pour le circuit analogique nécessitant une alimentation bipolaire. Deuxièmement, lorsque je testais mes effets, je me suis rendu compte qu’il y avait des pics de tensions aléatoires qui affectaient le signal. Ce problème venait du fait que le contrôleur ATMEL de la carte Mojo V3 échantillonne beaucoup trop vite, et par ce fait ne laisse pas assez de temps à ses convertisseurs analogues à numériques pour se décharger, ce qui fait en sorte qu’ils s’influencent tous. Troisièmement, je n’avais pas prévu de circuits de protection pour l’entrée du convertisseur analogique à numérique du codec audio. Lors de mes tests, je me suis rendu compte que le signal provenant de la guitare dépassait la tension maximale du convertisseur analogique à numérique du codec audio, et il fallait donc que je trouve une solution rapide et efficace. Celle-ci était d’implémenter un circuit de compression audio qui s’occuperait de normaliser le signal à une tension fixe, soit en augmentant les tensions faibles, et en réduisant les tensions trop hautes. Le circuit fonctionne bien pour protéger l’entrée du convertisseur analogique à numérique du Codec audio, cependant il n’est pas parfait et vient causer d’autres problèmes non voulus si la tension est trop élevée, ce qui le rend sujet à une future amélioration. Finalement, lors de la conception de mes circuits imprimés, je me suis rendu compte que les connecteurs de l’écran graphique LCD étaient trop larges pour simplement y attacher un connecteur et que la tension du niveau logique haut était plus élevée que celle de mon FPGA. Cela à donc mené à devoir créer rapidement une deuxième plaquette spécialement pour l’écran, ainsi que d’imaginer une façon de connecter cette plaquette avec la plaquette principale.

### Connaissances acquises pendant le projet

Durant la conception du projet, j’ai acquis de nombreuses connaissances par rapport à plusieurs aspects. Premièrement, j’ai beaucoup appris sur le langage VHDL ainsi que sur les FPGA. Une d’entre elles était l’utilisation des variables en VHDL. Celle-ci sont uniquement disponible à l’intérieur de processus et ont la caractéristique de changer instantanément de valeur lors d’un coup d’horloge, contrairement aux signaux qui eux sont retardés d’un coup d’horloge. Il y a ensuite l’utilisation de la directive « generate » pour générer plusieurs circuits similaires rapidement. En programmant un « for generate » en VHDL, on peut rapidement générer un circuit complexe utilisant les mêmes composantes VHDL, par exemple de générer un circuit à décalage de 24 bits en générant 24 bascules en série. Un autre aspect acquis du langage VHDL lors de la conception du projet fut l’utilisation de nombres de types réels. Ce type est très utile lors de la conception de banc de tests, car il permet d’utiliser des équations de types logarithmiques, exponentiels ainsi que des divisions rapidement et facilement. Ils ne sont malheureusement pas synthétisables, cependant ils peuvent être utilisés pour la création de constantes, ce qui peut s’avérer utile lors de la conception d’un circuit. Finalement, ce projet m’a permis d’avoir une meilleure conception de la façon dont le code écrit est synthétisé. En effet, le code VHDL affecte directement le choix des composantes internes par l’outil de synthèse, et étant donné que les ressources sont limitées, on peut choisir d’orienter notre code vers l’utilisation d’une composante spécifique pour alléger le reste des composantes. Par exemple, si on ne spécifie pas l’utilisation d’un bloc de mémoire vive interne, l’outil de synthèse pourrait choisir d’utiliser des bascules. En faisant cela, on vient directement perdre beaucoup d’espace interne qui pourrait être utilisé pour d’autres éléments logiques. Deuxièmement, j’ai appris à utiliser un codec audio. Ceux-ci suréchantillonnent le signal audio dans le but d’améliorer la résolution du signal audio, de réduire le bruit et de réduire la taille des filtres d’anti-repliement. Aussi, ceux-ci utilisent quelques protocoles de communications dédiés au transfert de données audios modulés par impulsions codées (PCM). Le protocole que j’ai dû apprendre était le I²S, soit un standard développé par Philips Semiconductor permettant la communication de données modulées par impulsions codées entre deux composantes. Troisièmement, j’ai appris à concevoir des circuits imprimés dans l’optique de réduire le plus possible le bruit généré par les composantes numériques dans les circuits analogiques. Pour ce faire, j’ai utilisé un document mis par Normand Provencher sur le wiki TGE (voir annexe) pour comprendre plusieurs concepts importants lors de la conception de circuit imprimé comportant des circuits analogiques et numériques comme le placement des composantes par rapport au type de circuits et par rapport à la fréquence, la façon de créer un point neutre pour les retours de courants ainsi que la façon d’utiliser des condensateurs de découplage et de dérivation. Finalement, j’ai appris à utiliser un écran graphique de type LCD pour pouvoir afficher des images programmables.

# Annexes

1. Document sur la conception de plaquette de circuit imprimé mixte analogique numérique (http://wikitge.cmaisonneuve.profweb.ca/images/Directives_pour_la_conception_de_plaquettes_de_circuits_imprim%C3%A9s.pdf)
2. Code source complet
3. Circuits (inclus fichiers gerber)
4. Fiches techniques
5. Librairie de pièces
6. Travail sur le paramètre « Tone »
7. Site web Nandland pour les références en VHDL (https://www.nandland.com/)
8. Site web ICS.uci.edu pour les références en VHDL
9. Schémas de la carte Mojo V3 (http://cdn.embeddedmicro.com/mojo/v3-sch.pdf)

Notes : Les fiches techniques pour le FPGA Spartan 6 de la carte Mojo V3 n’ont pas étés inclus dans les fiches techniques du projet. La raison est qu’elles sont multiples et volumineuses. Pour les retrouver, il est préférable de les rechercher sur le site internet de Xilinx (https://www.xilinx.com/).
