lolo2438/VHDL_GUITAR_PEDAL/interface.jpg

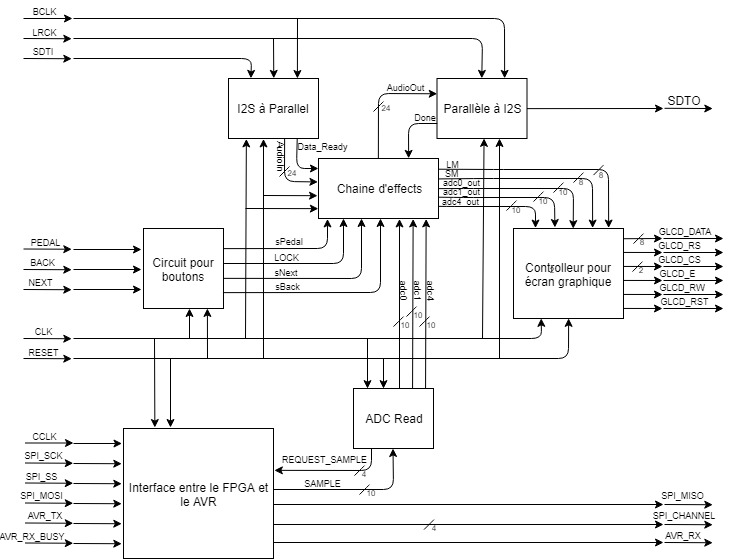
interface.jpg
