lolo2438/VHDL_GUITAR_PEDAL/Rapport final/Paramètre Tone/FloatToHex/Fir graph/6500Hz.PNG

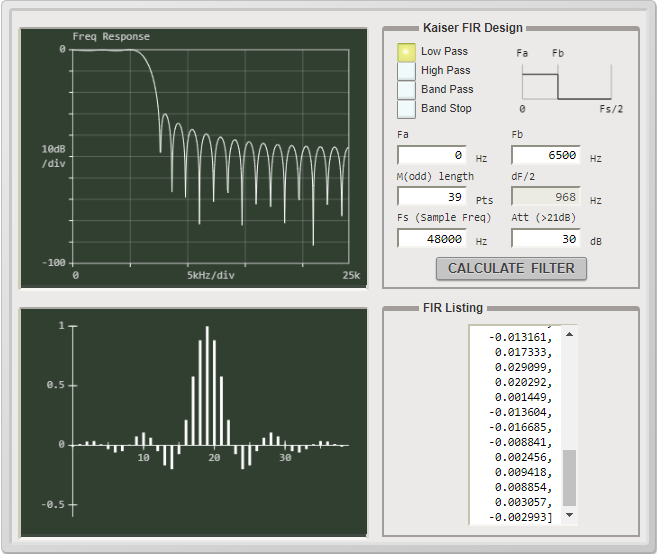
Rapport final/Paramètre Tone/FloatToHex/Fir graph/6500Hz.PNG
