lolo2438/VHDL_GUITAR_PEDAL/TOP.png

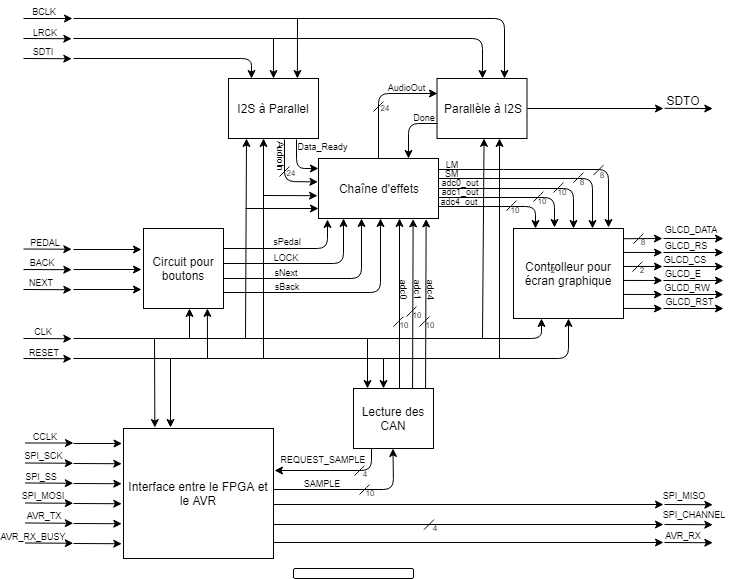
TOP.png
