lolo2438/VHDL_GUITAR_PEDAL/Circuit/PiecesRapportReal.xlsx

Processeur
Nom | RefDes | Description | Nb | # Digikey
Mojo V3 | n/a* | Carte FPGA | 1 | 1568-1575-ND
Composantes passives
Nom | RefDes | Description | Nb | # Digikey
0.1uF | C1,C2,C9,C11,C13-15,C17,(C1-C5,C7) | Condensateur | 14 | 478-3755-1-ND
10uF | C4-C6,C10,C16,C19,(C8) | Condensateur | 7 | PCE3948CT-ND
22uF | C8,C11 | Condensateur | 2 | PCE4240CT-ND
0.47uF | C18 | Condensateur | 1 | 1276-6483-1-ND
2.2uF | C3 | Condensateur | 1 | PCE4017CT-ND
1uF | C12,(C6) | Condensateur | 2 | 587-1291-1-ND
10kΩ | R11,R6,R8,R9,R10 | Résistance | 5 | 311-10.0KCRCT-ND
120kΩ | R13 | Résistance | 1 | 311-120KCRCT-ND
1.5kΩ | R2 | Résistance | 1 | 311-1.50KCRCT-ND
1MΩ | R12 | Résistance | 1 | 311-1.00MCRCT-ND
100KΩ | R7 | Résistance | 1 | 311-100KCRCT-ND
5.1Ω | R1 | Résistance | 1 | YAG3373CT-ND
POT10KΩ | (R1) | Potentiomètre pour Écran | 1 | CT6EW103-ND
POT10KΩ | R3-R5 | Potentiomètres pour effets | 3 | 987-1731-ND
Fuse | F1 | Fusible | 1 | F2110CT-ND
PBUTTON | S2,S3 | Bouton suivant et précédent | 2 | EG2031-ND
PSWITCH | S1 | Bouton activant pedale | 1 | n/a*
**() = circuit ecran
Composantes actives
Nom | RefDes | Description | Nb | # Digikey
TL074 | U5 | Amplificateur opérationnnel | 1 | 296-7198-1-ND
MMBT3906 | Q1 | Transistor BJT | 1 | MMBT3906TT1GOSCT-ND
MMBF4392 | Q2 | Transistor JFET | 1 | MMBF4392LT1GOSCT-ND
LD111750 | U1 | Regulateur 5V | 1 | 497-1243-6-ND
LD111733 | U4 | Régulateur 3.3V | 1 | 497-1228-1-ND
LM7905 | U2 | Régulateur -5V | 1 | LM7905CTFS-ND
TLV702 | (U4) | Régulateur 3.5V | 1 | 296-34811-1-ND
LF50CDT | (U5) | Régulateur 5V | 1 | 497-1534-1-ND
TXB0108 | (U2,U3) | Passerèle 3.3V à 5V | 2 | 296-21527-1-ND
AK4556 | U3 | Codec audio 24 bit | 1 | 974-1021-1-ND
OSC | Y1 | Oscillateur 24.576MHz | 1 | 1664-1104-1-ND
GLCD | (U1) | Écran graphique LCD | 1 | NHD-12864WG-BTGH-T#N-ND
connecteurs
Nom | RefDes | Description | Nb | # Digikey
HDR 1x2M | J7-J9,J10,J12,J16,J17 | Connecteur polarisé 1x2 male | 7 | A1921-ND
HDR 1x2F | J7-J9,J10,J12,J16,J18 | Connecteur polarisé 1x2 Femelle | 7 | A99613-ND
HDR 1x3M | J4,J11,J13 | Connecteur polarisé 1x3 male | 3 | A19470-ND
HDR 1x3F | J4,J11,J14 | Connecteur polarisé 1x3 Femelle | 3 | A99614-ND
HDR 25x2M | J1,J2 | Connecteur 25x2 male | 2 | 609-3488-ND**
HDR 5x2M | J3 | Connecteur 5x2 male | 1 | 609-3488-ND**
HDR 2x10M | J14 | Connecteur 2x10 male | 1 | ED10524-ND
HDR 2x10M | (J1) | Connecteur 2x10 male | 1 | ED10536-ND
HDR 2x10F | J14,(J1) | Connecteur 2x10 femelle | 2 | ED10503-ND
HDR 1x20F | (U1)* | Connecteur 1x20 femelle | 1 | S7018-ND
Con Alim | J15 | Connecteur pour Alim | 1 | CP-066A-ND
Con sertir | n/a | Connecteur pour sertir | 50 | A100453CT-ND
Jack 1/4 | J5,J6 | audio Jack | 2 | SC1316-ND
Cable | n/a | Cable ruban 20 position | 1 | MC20G-5-ND
Con 9V | n/a | Connecteur pour batterie 9V | 1 | 36-232-ND
accessoires
Nom | RefDes | Description | Nb | # Digikey
Knob | n/a | Poignés pour potentiomètres | 3 | 450-1736-ND
Alim9V | n/a | Alimentation externe 9V | 1 | 1470-2773-ND
Batt9V | n/a | Batterie 9V | 1 | P687-ND
Boitier | n/a | Boitier | 1 | n/a*
