lolo2438/VHDL_GUITAR_PEDAL/VHDL/par_usage_statistics.html

Par Statistics

Total Non-vccgnd Signals=4644

Total Non-vccgnd Design Pins=14610

Total Non-vccgnd Conns=14610

Total Non-vccgnd Timing Constrained Conns=14242

Phase 1 CPU=7.1 sec

Phase 2 CPU=7.8 sec

Phase 3 CPU=16.4 sec

Phase 4 CPU=17.2 sec

Phase 5 CPU=23.0 sec

Phase 6 CPU=23.0 sec

Phase 7 CPU=23.0 sec

Phase 8 CPU=23.0 sec

Phase 9 CPU=23.2 sec

Phase 10 CPU=24.3 sec

AvgWirelenPerPin Fanout 1=3.0

AvgWirelenPerPin Fanout 2=4.0

AvgWirelenPerPin Fanout 3=3.0

AvgWirelenPerPin Fanout 4=4.0

AvgWirelenPerPin Fanout 10=3.3

AvgWirelenPerPin Fanout 50=3.5

AvgWirelenPerPin Fanout 100=8.7

AvgWirelenPerPin Fanout 500=2.6

AvgWirelenPerPin Fanout 5000=4.4

AvgWirelenPerPin Fanout 20000=0.0

AvgWirelenPerPin Fanout 50000=0.0

AvgWirelenPerPin Fanout 100000=0.0

IRR Gamma=5.6273
