lolo2438/VHDL_GUITAR_PEDAL/Rapport final/Fiches techniques/OSC.pdf

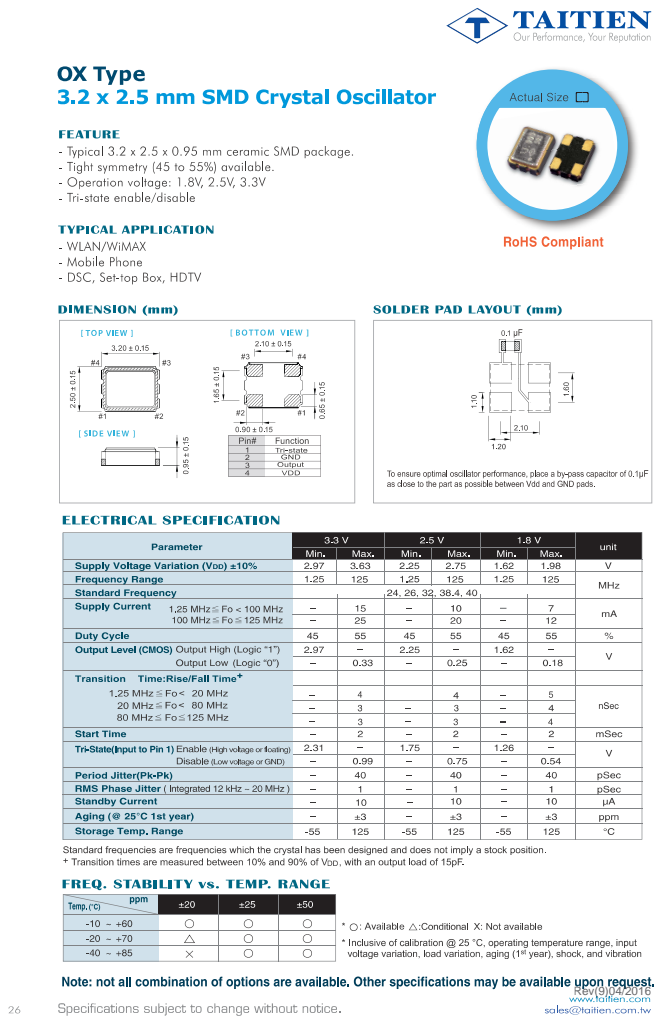
[picture p34: page 1]
Rev(9)04/2016
