lolo2438/VHDL_GUITAR_PEDAL/(list of files, drawings)

Other design files:
Rapport final/Circuits/CircuitLCD/CircuitLCD.ms13
Rapport final/Circuits/CircuitPrincipal/CircuitPrincipal.ms13
