lolo2438/VHDL_GUITAR_PEDAL/(commit log)

2017-12-27 Initial push
    [TOP_pad.csv]
2017-12-27 Added circuit and fixed I2S_INTERFACE
    [Circuit.ms13, I2S_TB_isim_beh.exe_main.nt64.obj, TOP_pad.csv, a_3069662272_3212880686.nt64.obj, a_3569781776_2372691052.nt64.obj, p_1242562249.nt64.obj, p_2592010699.nt64.obj]
2018-01-23 Mod circuit + Top UCF
    cleanup text files
    [Circuit.ms13]
2018-01-23 Clean up
    [I2S_TB_isim_beh.exe_main.nt64.obj, a_3069662272_3212880686.nt64.obj, a_3569781776_2372691052.nt64.obj, p_1242562249.nt64.obj, p_2592010699.nt64.obj]
2018-01-23 ADD i2s V2 for testing
    [I2STB2_isim_beh.exe_main.nt64.obj, a_2536358194_2372691052.nt64.obj, a_3069662272_3212880686.nt64.obj, p_2592010699.nt64.obj]
2018-01-26 Mod circuti + Started routing
    [Circuit.ms13]
2018-01-29 work on circuits
2018-01-29 update circuit
    [Circuit.ms13]
2018-01-30 modif i2s
    PROBLEME: BIT LE PLUS SIGNIFICATIF INVERSÉ
    [I2S_TB_isim_beh.exe_main.nt64.obj, TOP_pad.csv, a_3069662272_3212880686.nt64.obj, a_3569781776_2372691052.nt64.obj]
2018-01-31 Added I2S_interface v3
    [I2STB2_isim_beh.exe_main.nt64.obj, I2S_TB_isim_beh.exe_main.nt64.obj, TOP_pad.csv, a_2536358194_2372691052.nt64.obj, a_3069662272_3212880686.nt64.obj, a_3569781776_2372691052.nt64.obj, p_2592010699.nt64.obj]
2018-02-05 TB + v1 rework
    [a_1335952598_3212880686.nt64.obj, a_1949178628_2372691052.nt64.obj, a_3860840486_3212880686.nt64.obj, p_1242562249.nt64.obj, p_2592010699.nt64.obj, testbench_isim_beh.exe_main.nt64.obj]
2018-02-06 I2S Rework
    [a_1335952598_3212880686.nt64.obj, a_1949178628_2372691052.nt64.obj, a_3860840486_3212880686.nt64.obj, p_1242562249.nt64.obj, p_2592010699.nt64.obj, testbench_isim_beh.exe_main.nt64.obj]
2018-02-13 Added template for distortion and volume
    [TOP_pad.csv]
2018-02-14 added volume Control module
    [TOP_pad.csv]
2018-02-15 updated volume
    [a_1076091511_2372691052.nt64.obj, a_1537880347_3212880686.nt64.obj, p_1242562249.nt64.obj, p_2592010699.nt64.obj, volumeControlTB_isim_beh.exe_main.nt64.obj]
2018-02-16 cleanup + done volume module
    [a_1076091511_2372691052.nt64.obj, a_1537880347_3212880686.nt64.obj, p_1242562249.nt64.obj, p_2592010699.nt64.obj, volumeControlTB_isim_beh.exe_main.nt64.obj]
2018-02-20 Big update
    Fixed Volume control,
    Added buff in/out,
    added ADC select,
    optimized pedal processing,
    fixed bunch of warnings
    [ADC_Read.vhd, Buffer_In.vhd, Buffer_Out.vhd, Button_Processing.vhd, Detecteur_Front.vhd, PedalControl.vhd, PedalCtrlTB.vhd]
2018-02-20 Fixed adc module
2018-02-22 pieces a acheter
    [Circuit.ms13, Pièces.xlsx]
2018-02-27 tremolo failed build
    [Circuit.ms13, TOP_pad.csv, a_0261224879_3212880686.nt64.obj, a_1742778501_2372691052.nt64.obj, p_1242562249.nt64.obj, p_2592010699.nt64.obj, tremol_tb_isim_beh.exe_main.nt64.obj]
2018-02-28 Tremolo fix, to test
    [TOP_pad.csv, a_0261224879_3212880686.nt64.obj, a_1742778501_2372691052.nt64.obj, p_1242562249.nt64.obj, p_2592010699.nt64.obj, tremol_tb_isim_beh.exe_main.nt64.obj]
2018-03-02 tremolo doesnt work
    [TOP_pad.csv]
2018-03-05 tremolo and dist work to test
    [TOP_pad.csv, a_0261224879_3212880686.nt64.obj, a_1742778501_2372691052.nt64.obj, p_1242562249.nt64.obj, p_2592010699.nt64.obj, tremol_tb_isim_beh.exe_main.nt64.obj]
2018-03-05 generated clock is the problem
    [TOP_pad.csv, a_0261224879_3212880686.nt64.obj, a_1742778501_2372691052.nt64.obj, p_1242562249.nt64.obj, tremol_tb_isim_beh.exe_main.nt64.obj]
2018-03-05 update circuit
    [Circuit.ms13]
2018-03-06 tremolo prob found => freq
    [TOP_pad.csv, a_0261224879_3212880686.nt64.obj, a_1742778501_2372691052.nt64.obj, p_1242562249.nt64.obj, p_2592010699.nt64.obj, tremol_tb_isim_beh.exe_main.nt64.obj]
2018-03-08 modif circuit
    [Circuit.ms13, Pièces.xlsx]
2018-03-09 updated circuit and parts
    [Circuit.ms13, Pièces.xlsx]
2018-03-09 circuit & part update
    [Circuit.ms13, Pièces.xlsx]
2018-03-13 Updated circuits
    [Circuit.ms13, LCD_Header.ms13, Pièces.xlsx]
2018-03-19 Big update
    Circuits, lcd, effects etc.
    [Circuit.ms13, LCD_Header.ms13, Pièces.xlsx, TOP_pad.csv]
2018-03-20 added audio compression circuit
    [Circuit.ms13]
2018-03-23 footprints added + lcdV2
    [Circuit.ms13, Pièces.xlsx]
2018-03-23 LCD Header v2 done
    [Pièces.xlsx]
2018-03-26 big work
    -- Modified pedal button behavior,
    -- finished circuits
    -- added distortion graphics
    [Circuit.ms13, Distortion pixel gen.xlsm, LCD_Header.ms13, Pièces.xlsx, TOP_pad.csv]
2018-03-27 Circuit main V2
    [Pièces.xlsx]
2018-03-27 CircuitV2 Done
    [Circuit.ms13]
2018-03-28 Generated Gerber
    [Final - Board Outline.gbr, Final - Copper Bottom.gbr, Final - Copper Inner 1.gbr, Final - Copper Inner 2.gbr, Final - Copper Top-Copper Bottom.drl, Final - Copper Top.gbr, Final - Drill Symbols-Copper Top-Copper Bottom.gbr, Final - Drill-Copper Top-Copper Bottom.gbr]
2018-03-28 Gerber zip
2018-04-02 Stuff
    add rapport
    [a_0261224879_3212880686.nt64.obj, a_1742778501_2372691052.nt64.obj, p_1242562249.nt64.obj, p_2592010699.nt64.obj, tremol_tb_isim_beh.exe_main.nt64.obj]
2018-04-03 standard push
    [a_0261224879_3212880686.nt64.obj, a_1742778501_2372691052.nt64.obj, p_1242562249.nt64.obj, p_2592010699.nt64.obj, tremol_tb_isim_beh.exe_main.nt64.obj]
2018-04-03 removed test leds + moar locked modules
2018-04-10 working on lcd
    [LCD_CONTROLLER_TB_isim_beh.exe_main.nt64.obj, TOP_pad.csv, a_0821306143_2372691052.nt64.obj, a_4171821358_3212880686.nt64.obj, p_1242562249.nt64.obj, p_2592010699.nt64.obj]
2018-04-10 LCD tested and working, need to add for generate
    [LCD_CONTROLLER_TB_isim_beh.exe_main.nt64.obj, TOP_pad.csv, a_0821306143_2372691052.nt64.obj, a_4171821358_3212880686.nt64.obj, p_1242562249.nt64.obj, p_2592010699.nt64.obj]
2018-04-13 lcd weird behavior
    [LCD_CONTROLLER_TB_isim_beh.exe_main.nt64.obj, TOP_pad.csv, a_0821306143_2372691052.nt64.obj, a_4171821358_3212880686.nt64.obj, p_1242562249.nt64.obj, p_2592010699.nt64.obj]
2018-04-13 Found the adc problem, Lcd still not correctly working
    [ADC_READ_TB_isim_beh.exe_main.nt64.obj, TOP_pad.csv, a_1061716724_2372691052.nt64.obj, a_1130819202_3212880686.nt64.obj, a_4171821358_3212880686.nt64.obj]
2018-04-13 Possible fix for adc
    [ADC_Read.vhd, LCD_Controller.vhd]
2018-04-14 possible fix
    for:
    - Tremolo rate
    - ADC false values
    - glcd controller
    [LCD_CONTROLLER_TB_isim_beh.exe_main.nt64.obj, a_0821306143_2372691052.nt64.obj, a_4171821358_3212880686.nt64.obj, p_1242562249.nt64.obj]
2018-04-16 lcd working, adc working
    [TOP_pad.csv]
2018-04-17 update
    -Automatic gain in dist
    -pixel img update
    [Distortion pixel gen.xlsm]
2018-04-18 removed distortion peak control, added adc img
    [ADC_READ_TB_isim_beh.exe_main.nt64.obj, LCD_CONTROLLER_TB_isim_beh.exe_main.nt64.obj, TOP_pad.csv, a_0821306143_2372691052.nt64.obj, a_1061716724_2372691052.nt64.obj, a_1130819202_3212880686.nt64.obj, a_4171821358_3212880686.nt64.obj, p_1242562249.nt64.obj]
2018-04-20 Added Adc1 and 4, added dist,tone,vol
    [Distortion pixel gen.xlsm, TOP_pad.csv]
2018-04-23 Update
    - Rapport
    - Circuits
    - Delay
    [Circuit.ms13, Pièce_Rapport.xlsx, Pièces.xlsx]
2018-04-23 to rm -> delay fifo
    [TOP_pad.csv]
2018-04-24 Rm new distortion behavior for old one
    [TOP_pad.csv]
2018-04-25 Whew
    Coded everything to save parameters,
    added lock icon
    added pedal activated icon
    big update
    [Distortion pixel gen.xlsm]
2018-04-27 fixed lcd, problem with boot
    [Distortion pixel gen.xlsm]
2018-04-29 Rapport + Circuit V2 Rev1
    [Circuit.ms13]
2018-05-01 Tremolo img added
    [Tremolo pixel gen.xlsm]
2018-05-01 update comments, possible fix
    [Buffer_In.vhd, Buffer_Out.vhd, Distortion.vhd, LCD_Controller.vhd, PedalControl.vhd, Tremolo.vhd, effectChain.vhd]
2018-05-01 found lcd problem
    [TOP_pad.csv]
2018-05-02 Added pictures of FIR filters
2018-05-04 Added distGain
    [TOP_pad.csv]
2018-05-04 reduced distorsion gain
    [TOP_pad.csv]
2018-05-07 Ajout bilan des travaux
2018-05-08 Added circuit Diagram + distorsion
2018-05-10 Clean up parts
    [PiecesRapportReal.xlsx]
2018-05-14 rapport stuff
    [CircuitLCD - Board Outline.gbr, CircuitLCD - Copper Bottom.gbr, CircuitLCD - Copper Top-Copper Bottom.drl, CircuitLCD - Copper Top.gbr, CircuitLCD - Drill Symbols-Copper Top-Copper Bottom.gbr, CircuitLCD - Drill-Copper Top-Copper Bottom.gbr, CircuitLCD - Silkscreen Bottom.gbr, CircuitLCD - Silkscreen Top.gbr]
